JakobZoephel/Entwicklung-eines-Sensor-Arrays-zur-automatischen-Geruchserkennung/Nase_Processing/data/Atem_bars.jpg

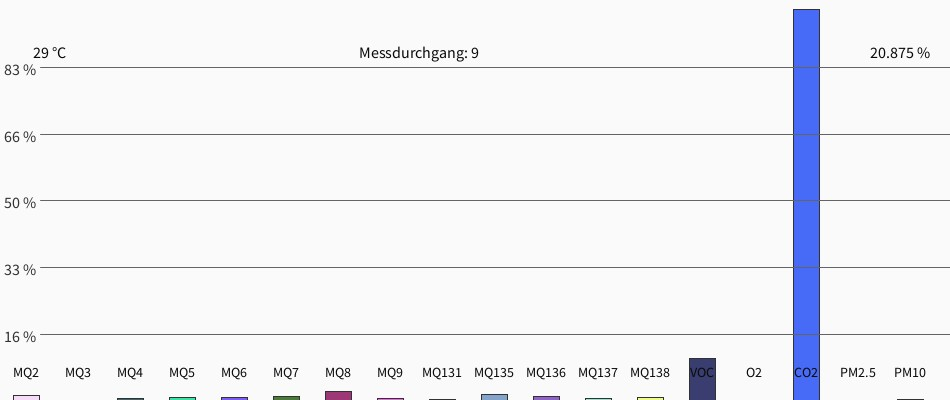
Nase_Processing/data/Atem_bars.jpg
