JakobZoephel/Entwicklung-eines-Sensor-Arrays-zur-automatischen-Geruchserkennung/Nase_Processing/data/Essig_bars.jpg

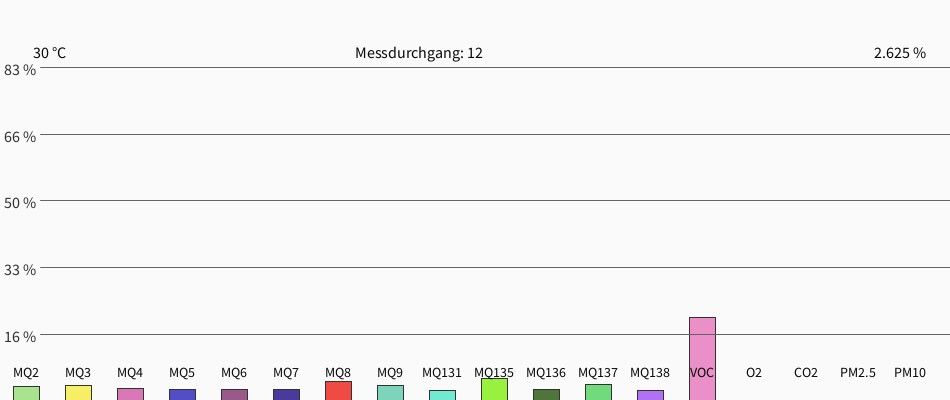
Nase_Processing/data/Essig_bars.jpg
