JakobZoephel/Entwicklung-eines-Sensor-Arrays-zur-automatischen-Geruchserkennung/Nase_Processing/data/NagellackEntferner_bars.jpg

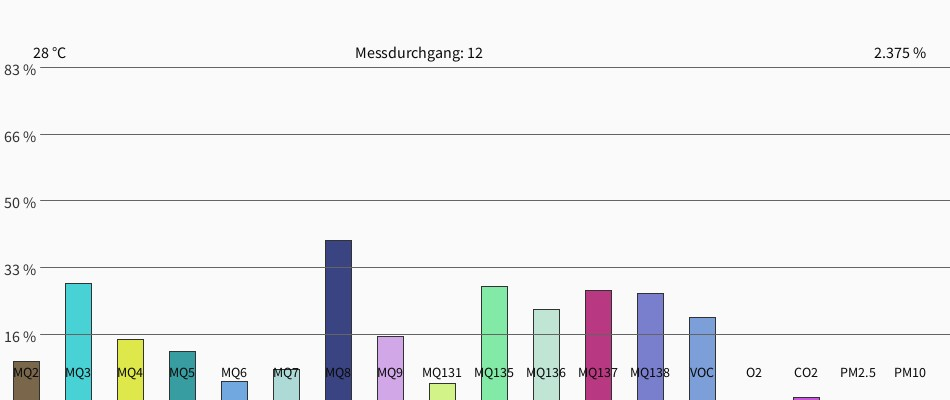
Nase_Processing/data/NagellackEntferner_bars.jpg
