JakobZoephel/Entwicklung-eines-Sensor-Arrays-zur-automatischen-Geruchserkennung/Nase_Processing/data/NagellackEntferner_lines.jpg

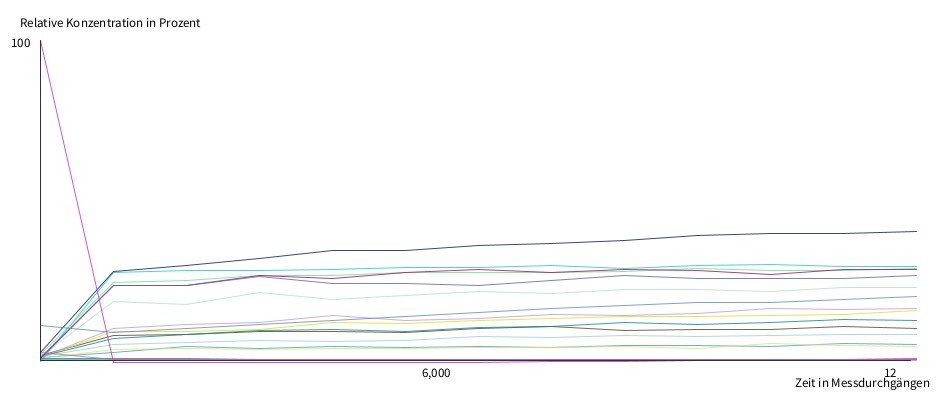
Nase_Processing/data/NagellackEntferner_lines.jpg
