JakobZoephel/Entwicklung-eines-Sensor-Arrays-zur-automatischen-Geruchserkennung/Nase_Processing/data/Orange_lines.jpg

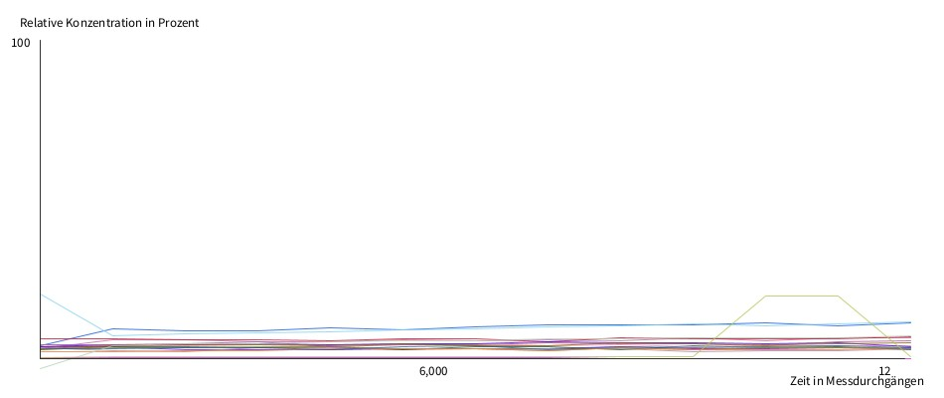
Nase_Processing/data/Orange_lines.jpg
